gituser-rk/ESP32-LED-Matrix-SPI-MQTT/esp32-led-matrix-v/LedMatrix.cpp

#include <SPI.h>
#include "LedMatrix.h"
#include "cp437font.h"

/**
 * Heavily influenced by the code and the blog posts from https://github.com/nickgammon/MAX7219_Dot_Matrix
 */
LedMatrix::LedMatrix(byte numberOfDevices, int8_t sck, int8_t miso, int8_t mosi, byte slaveSelectPin) {
    myNumberOfDevices = numberOfDevices;
    mySlaveSelectPin = slaveSelectPin;
    cols = new byte[numberOfDevices * 8];
    _sck = sck;
    _miso = miso;
    _mosi = mosi;
}

/**
 *  numberOfDevices: how many modules are daisy changed togehter
 *  slaveSelectPin: which pin is controlling the CS/SS pin of the first module?
 */
void LedMatrix::init() {
    pinMode(mySlaveSelectPin, OUTPUT);
    
    SPI.begin ( _sck,  _miso,  _mosi,  mySlaveSelectPin);
    SPI.setDataMode(SPI_MODE0);
    SPI.setClockDivider(SPI_CLOCK_DIV128);
    for(byte device = 0; device < myNumberOfDevices; device++) {
        sendByte (device, MAX7219_REG_SCANLIMIT, 6);   // show all 8 digits
        sendByte (device, MAX7219_REG_DECODEMODE, 0);  // using an led matrix (not digits)
        sendByte (device, MAX7219_REG_DISPLAYTEST, 0); // no display test
        sendByte (device, MAX7219_REG_INTENSITY, 0);   // character intensity: range: 0 to 15
        sendByte (device, MAX7219_REG_SHUTDOWN, 1);    // not in shutdown mode (ie. start it up)
    }
}

void LedMatrix::sendByte (const byte device, const byte reg, const byte data) {
    int offset=device;
    int maxbytes=myNumberOfDevices;
    
    for(int i=0;i<maxbytes;i++) {
        spidata[i] = (byte)0;
        spiregister[i] = (byte)0;
    }
    // put our device data into the array
    spiregister[offset] = reg;
    spidata[offset] = data;
    // enable the line
    digitalWrite(mySlaveSelectPin,LOW);
    // now shift out the data
    for(int i=0;i<myNumberOfDevices;i++) {
        SPI.transfer (spiregister[i]);
        SPI.transfer (spidata[i]);
    }
    digitalWrite (mySlaveSelectPin, HIGH);
    
}

void LedMatrix::sendByte (const byte reg, const byte data) {
    for(byte device = 0; device < myNumberOfDevices; device++) {
        sendByte(device, reg, data);
    }
}

void LedMatrix::setIntensity(const byte intensity) {
    sendByte(MAX7219_REG_INTENSITY, intensity);
}

void LedMatrix::setCharWidth(byte charWidth) {
    myCharWidth = charWidth;
}

void LedMatrix::setTextAlignment(byte textAlignment) {
    myTextAlignment = textAlignment;
    calculateTextAlignmentOffset();
}

void LedMatrix::calculateTextAlignmentOffset() {
    switch(myTextAlignment) {
        case TEXT_ALIGN_LEFT:
            myTextAlignmentOffset = 0;
            break;
        case TEXT_ALIGN_LEFT_END:
            myTextAlignmentOffset = myNumberOfDevices * 8;
            break;
        case TEXT_ALIGN_RIGHT:
            myTextAlignmentOffset = myText.length() * myCharWidth - myNumberOfDevices * 8;
            break;
        case TEXT_ALIGN_RIGHT_END:
            myTextAlignmentOffset = - myText.length() * myCharWidth;
            break;
    }
    
}

void LedMatrix::clear() {
    for (byte col = 0; col < myNumberOfDevices * 8; col++) {
        cols[col] = 0;
    }
    
}

void LedMatrix::commit() { //shift the data not on the column but on the row
	byte Jav_cols[myNumberOfDevices * 8];
	for (byte digit = 0; digit < 4; digit++){
		for (byte sor = 0; sor < 8; sor++){
			for (byte oszlop = 0; oszlop < 8; oszlop++){
				bitWrite(Jav_cols[7-sor +(digit*8)], oszlop, bitRead(cols[oszlop+(digit*8)], sor)); 
			}
		}
	}
	for (byte digit = 0; digit < 4; digit++){
		for (byte oszlop = 0; oszlop < 8; oszlop++){
			sendByte(digit, oszlop, (Jav_cols[oszlop+24-digit*8]));
		}
	}
}


void LedMatrix::setText(String text) {
    myText = text;
    myTextOffset = 0;
    calculateTextAlignmentOffset();
}

void LedMatrix::setNextText(String nextText) {
    myNextText = nextText;
}

void LedMatrix::scrollTextRight() {
    myTextOffset = (myTextOffset + 1) % ((int)myText.length() * myCharWidth - 5);
}

void LedMatrix::scrollTextLeft() {
    myTextOffset = (myTextOffset - 1) % ((int)myText.length() * myCharWidth + myNumberOfDevices * 8);
    if (myTextOffset == 0 && myNextText.length() > 0) {
        myText = myNextText;
        myNextText = "";
        calculateTextAlignmentOffset();
    }
}

void LedMatrix::oscillateText() {
    int maxColumns = (int)myText.length() * myCharWidth;
    int maxDisplayColumns = myNumberOfDevices * 8;
    if (maxDisplayColumns > maxColumns) {
        return;
    }
    if (myTextOffset - maxDisplayColumns == -maxColumns) {
        increment = 1;
    }
    if (myTextOffset == 0) {
        increment = -1;
    }
    myTextOffset += increment;
}

void LedMatrix::drawText() {
    char letter;
    int position = 0;
    for (int i = 0; i < myText.length(); i++) {
        letter = myText.charAt(i);
        for (byte col = 0; col < 8; col++) {
            position = i * myCharWidth + col + myTextOffset + myTextAlignmentOffset;
            if (position >= 0 && position < myNumberOfDevices * 8) {
                setColumn(position, pgm_read_byte (&cp437_font [letter] [col]));
            }
        }
    }
}

void LedMatrix::setColumn(int column, byte value) {
    if (column < 0 || column >= myNumberOfDevices * 8) {
        return;
    }
    cols[column] = value;
}

void LedMatrix::setPixel(byte x, byte y) {
    bitWrite(cols[x], y, true);
}
